victordfmsc/caminafeliz-privacy/scad/img/bandeja_3.png

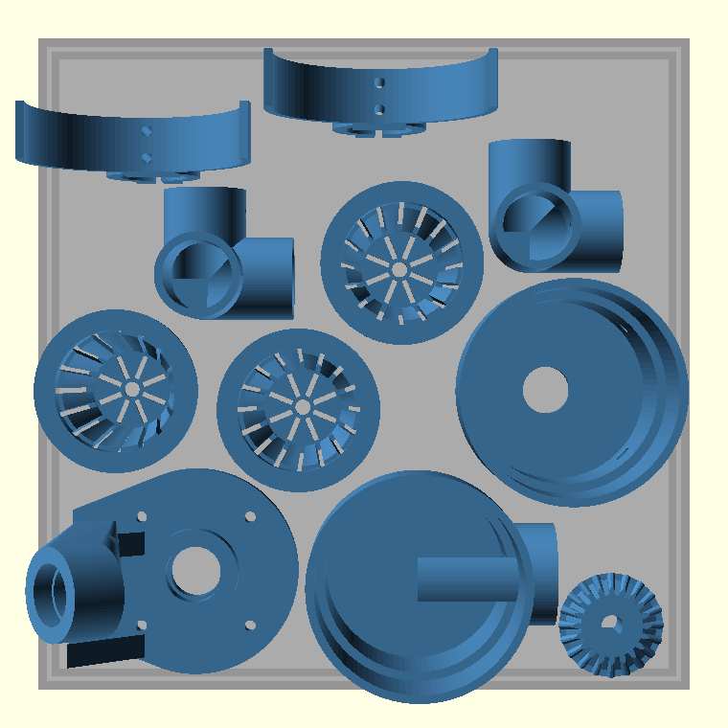
scad/img/bandeja_3.png
