victordfmsc/caminafeliz-privacy/scad/img/piezas/01_tornillo_arquimedes_calibre.png

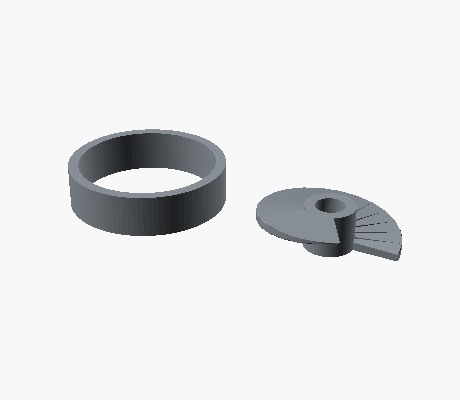
scad/img/piezas/01_tornillo_arquimedes_calibre.png
