victordfmsc/caminafeliz-privacy/scad/img/piezas/01_tornillo_arquimedes_carcasa.png

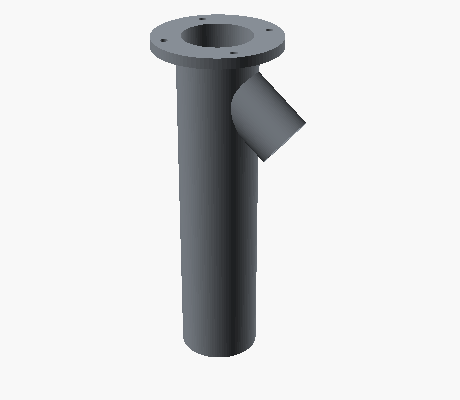
scad/img/piezas/01_tornillo_arquimedes_carcasa.png
