victordfmsc/caminafeliz-privacy/scad/img/piezas/01_tornillo_arquimedes_embudo.png

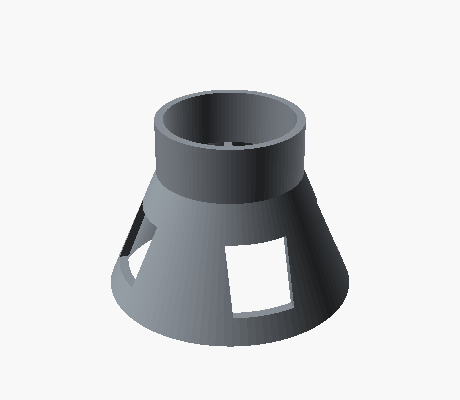
scad/img/piezas/01_tornillo_arquimedes_embudo.png
