victordfmsc/caminafeliz-privacy/scad/img/piezas/02_turbina_savonius_disco_sup.png

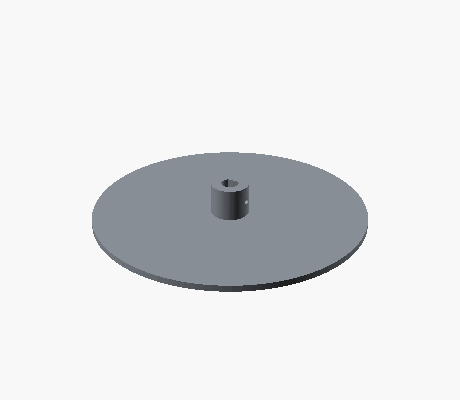
scad/img/piezas/02_turbina_savonius_disco_sup.png
