victordfmsc/caminafeliz-privacy/scad/img/piezas/02_turbina_savonius_rotor.png

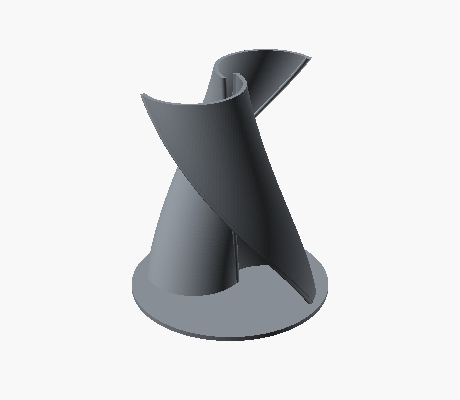
scad/img/piezas/02_turbina_savonius_rotor.png
