victordfmsc/caminafeliz-privacy/scad/img/piezas/03_soporte_rodamientos_acople.png

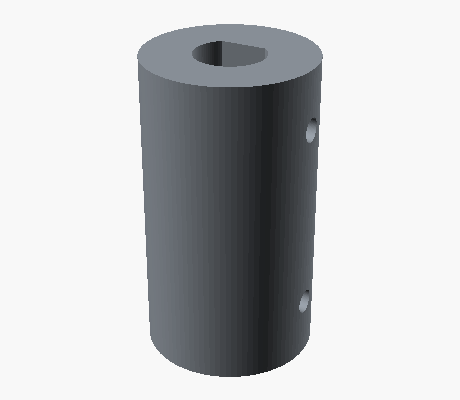
scad/img/piezas/03_soporte_rodamientos_acople.png
