victordfmsc/caminafeliz-privacy/scad/img/piezas/03_soporte_rodamientos_alojamiento.png

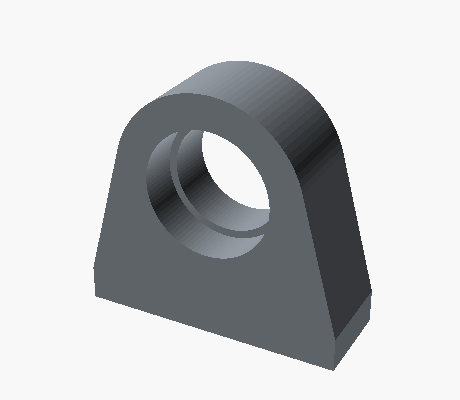
scad/img/piezas/03_soporte_rodamientos_alojamiento.png
