victordfmsc/caminafeliz-privacy/scad/img/piezas/03_soporte_rodamientos_engranaje.png

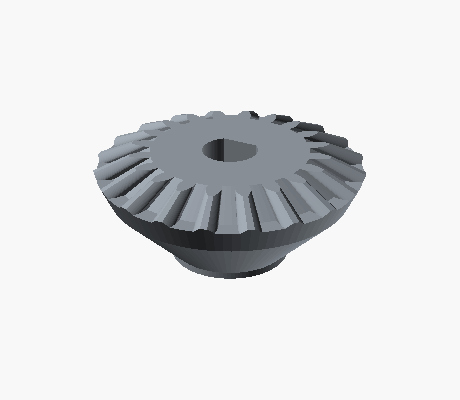
scad/img/piezas/03_soporte_rodamientos_engranaje.png
