victordfmsc/caminafeliz-privacy/scad/img/piezas/03_soporte_rodamientos_soporte.png

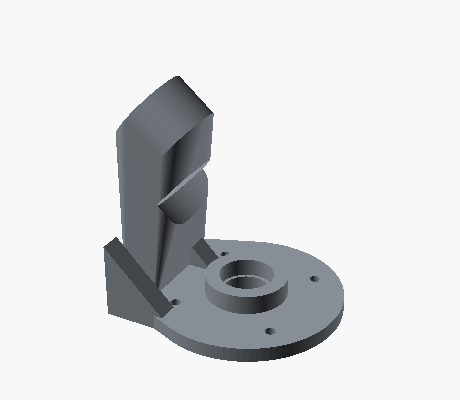
scad/img/piezas/03_soporte_rodamientos_soporte.png
