victordfmsc/caminafeliz-privacy/scad/img/piezas/04_tapones_pvc75_racor.png

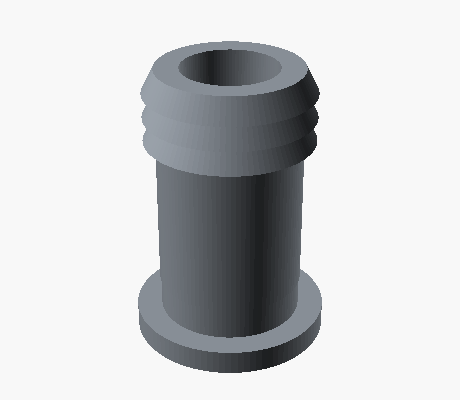
scad/img/piezas/04_tapones_pvc75_racor.png
