victordfmsc/caminafeliz-privacy/scad/img/piezas/04_tapones_pvc75_tapon_a.png

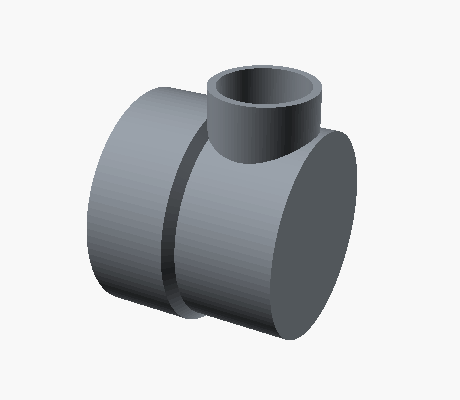
scad/img/piezas/04_tapones_pvc75_tapon_a.png
