victordfmsc/caminafeliz-privacy/scad/img/piezas/04_tapones_pvc75_tapon_b.png

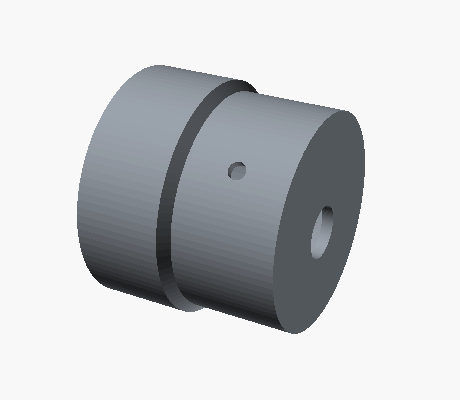
scad/img/piezas/04_tapones_pvc75_tapon_b.png
