victordfmsc/caminafeliz-privacy/scad/img/piezas/05_net_cup_50_plantilla.png

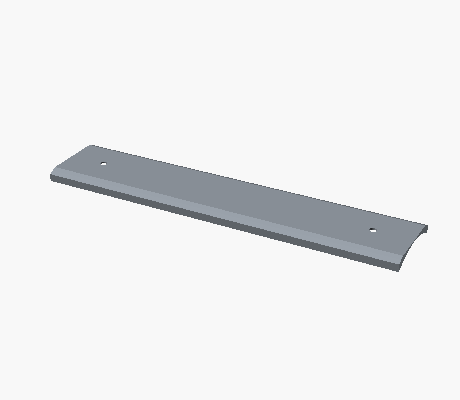
scad/img/piezas/05_net_cup_50_plantilla.png
