victordfmsc/caminafeliz-privacy/scad/img/piezas/06_estructura_abraz_canal.png

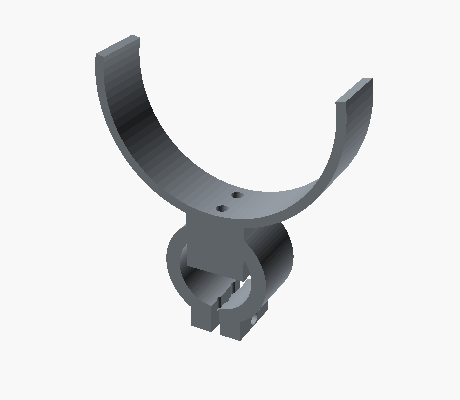
scad/img/piezas/06_estructura_abraz_canal.png
