victordfmsc/caminafeliz-privacy/scad/img/piezas/06_estructura_abraz_carcasa.png

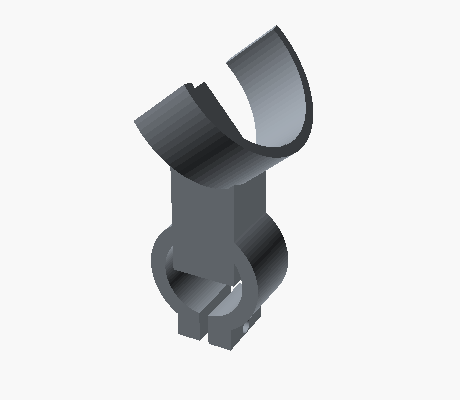
scad/img/piezas/06_estructura_abraz_carcasa.png
