victordfmsc/caminafeliz-privacy/scad/img/piezas/06_estructura_conector_3v.png

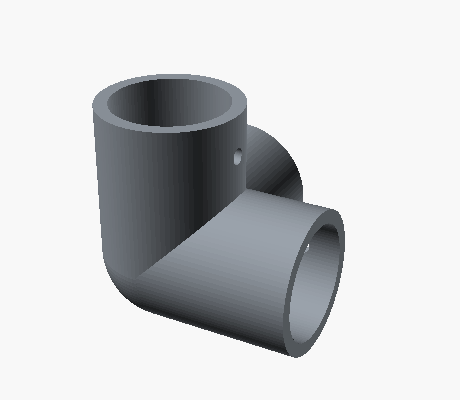
scad/img/piezas/06_estructura_conector_3v.png
