victordfmsc/caminafeliz-privacy/scad/img/piezas/06_estructura_sop_mastil.png

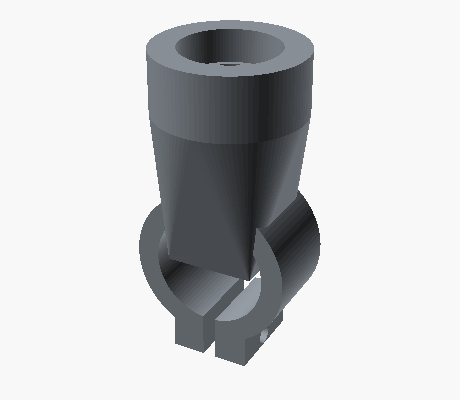
scad/img/piezas/06_estructura_sop_mastil.png
