victordfmsc/caminafeliz-privacy/scad/montaje.tpl.html

# Bomba de Arquímedes eólica

Montaje pieza a pieza de un sistema hidropónico accionado por viento. Veinte piezas impresas, tres cotas que hay que clavar y una ventana de nivel de 23 mm que decide si el invento funciona.

Piezas impresas

20 · 3 bandejas

Comprobaciones

{{N_CHECKS}} · {{ESTADO}}

Caudal en régimen

0,5 L/min

Inclinación de trabajo

40°

Vista general del sistema montado: rotor Savonius sobre mástil vertical, reenvío cónico, tornillo inclinado dentro del depósito y canal horizontal con vasos de cultivo

Conjunto en posición de trabajo, compuesto desde los STL reales. El agua sube por el tornillo, cae a plomo dentro del Tapón A y vuelve al depósito por el rebose.

Por qué funciona

## Cuatro números sostienen el diseño

Un tornillo de Arquímedes no bombea por ser un tornillo: bombea si sus cangilones cierran, si el caudal supera a la fuga y si la cadena de cotas deja el canal por debajo de la descarga y por encima del depósito. Los tres se cumplen, con margen medido.

0,280

Cierre de cangilones

k = S·tan(α)/(2π·Ri) debe ser < 1. El criterio se calcula con el radio interior: con el exterior daría por bueno un paso de 190 mm cuando el máximo real son 54.

0,28 L/min

Caudal neto

1,53 mL por vuelta menos la fuga por la holgura, a las 250 rpm en que el tornillo empieza a centrifugar. Renueva el canal cada 2,6 min.

×35 – ×216

Margen de par

Par estático del rotor frente al que exige el tornillo, de 2 a 5 m/s. Arranca con brisa floja: el sistema está limitado por velocidad, no por fuerza.

23 mm

Ventana de nivel

Entre −10 y +12 mm respecto a la base de la carcasa. Por debajo no coge agua; por encima el retorno deja de bajar por gravedad.

Arranque

## Lo que hace que un molino así no se mueva

El par que exige el tornillo es ridículo: 23 µN·m. Quien decide si arranca no es la carga hidráulica sino el rozamiento del tren, y con un Savonius el par disponible cae con el cuadrado de la velocidad del viento. Las dos cosas juntas explican por qué un aparato aparentemente bien hecho se queda quieto.

Rozamiento del tren | Par de arranque | Par disponible | Ø120×150 | Ø160×200
3 × 608ZZ con grasa de fábrica | 1500 µN·m | viento 1,5 m/s | 447 µN·m | 1058
3 × 608 desengrasado y aceite fino | 120 µN·m | viento 2 m/s | 794 | 1882
Buje del embudo, mojado | 200 µN·m | viento 3 m/s | 1786 | 4234
Engrane cónico impreso | 50 µN·m | viento 4 m/s | 3175 | 7526

3,0 m/s

Con rodamientos de fábrica

1750 µN·m de rozamiento. Es el caso del molino que «apenas se mueve»: hace falta viento fuerte solo para vencerse a sí mismo.

1,4 m/s

Desengrasados

370 µN·m. Quitar la grasa de los tres rodamientos es la intervención de mayor efecto de todo el proyecto, y es gratis.

0,9 m/s

Y rotor Ø160×200

El par del Savonius va con D²H: subir el rotor lo multiplica por 2,4 y además baja las rpm, que es lo que interesa porque el caudal ya está saturado.

2,4 m/s

Con álabe recto

Un Savonius de dos palas rectas tiene posiciones en las que el coeficiente de par cae a 0,10: puntos muertos. El álabe helicoidal de 120° los elimina.

### El emplazamiento pesa más que cualquier pieza

El par va con v², así que perder velocidad de viento se paga al cuadrado. Un balcón con barandilla, pared al lado y alero encima puede dejar la mitad de la velocidad libre, y con ella un cuarto del par.

Velocidad en el emplazamiento | Par que queda | Viento libre necesario para arrancar
100 % (mástil despejado) | 100 % | 1,4 m/s
70 % (por encima del pretil) | 49 % | 2,0 m/s
50 % (tras la barandilla) | 25 % | 2,7 m/s
35 % (rincón abrigado) | 12 % | 3,9 m/s

Regla práctica: el rotor tiene que estar por encima del pretil y a más de un diámetro de rotor de cualquier superficie. Si te obliga a subir el mástil 40 cm, súbelo: rinde más que cualquier cambio de pieza.

### Dos pruebas antes de meter agua

#### Parada libre

≥ 10 s desde 200 rpm

Con el tren montado y seco, lanza el rotor con la mano y cronometra. Bien ajustado y desengrasado ronda los 25 s. Si se para en menos de 10, no arrancará con brisa: busca el punto duro antes de seguir.

#### Par de arranque

10 g en un hilo

Enrolla un hilo en la varilla de Ø8 y cuelga peso. Con unos 10 g debe empezar a girar. Si necesita 40, los rodamientos siguen con la grasa de fábrica.

#### Si notas puntos duros

casi siempre es el engrane

Un par cónico montado 1 mm fuera de su cota entra forzado. Afloja el prisionero y separa el engranaje medio milímetro hasta que gire suave en toda la vuelta.

#### Cómo desengrasar

tres rodamientos, diez minutos

Quita un escudo con la punta de un cutter, lava la grasa con alcohol o disolvente, seca y pon una gota de aceite fino. Vuelve a poner el escudo por el lado del agua.

Cadena de cotas

## Dónde cae cada nivel

Todas las alturas están referidas a la base del tubo de la carcasa. La geometría de la conexión —radio del canal, manguito y carrera de la boquilla— consume unos 100 mm de altura, y por eso el tornillo de 180 mm no sobra: el mínimo viable son 157.

La boquilla es un tramo recto girado exactamente la inclinación de la carcasa: con el conjunto montado queda a plomo y su boca sale cortada en horizontal. Encaja 14 mm dentro del manguito con 1 mm de holgura radial, que admite 8° de desviación sin tocar.

Reenvío cónico

## Las dos cotas que no se pueden montar a ojo

Con turbina de eje vertical y tornillo a 40°, el ángulo entre ejes no es 90° sino 130°, y en una relación 1:1 cada cono primitivo vale la mitad: 65°. Los dos ejes se cortan en un punto —el ápice— y la posición axial de cada engranaje respecto a ese punto es lo que define el engrane.

Ambas cotas se miden entre la cara del buje que aloja el rodamiento y la base del cubo del engranaje. Son la forma práctica de colocar el ápice donde toca sin tener que medir hasta un punto que está en el aire.

Inventario

## Las veinte piezas

Todas salen de los seis módulos paramétricos y se imprimen en tres bandejas. Además hacen falta: varilla inoxidable Ø8 (257 y 299 mm), tres rodamientos 608ZZ, ocho prisioneros M3, diez tornillos M4, tubo PVC Ø75, tubo Ø25 para el bastidor y manguera Ø12 para el retorno.

{{INVENTARIO}}

Montaje

## Diez pasos, en este orden

El orden no es indiferente: hay dos pasos que solo se pueden hacer antes de otro. El embudo se monta con la varilla ya puesta, y el canal se coloca al final, deslizándolo bajo la boquilla en vez de mover la carcasa.

{{PASOS}}

Verificación

## Acta de comprobación

Estas comprobaciones no están escritas a mano: verificacion.py hace que OpenSCAD evalúe cada módulo y devuelva sus propias variables, y sobre esos números comprueba ajustes, alineaciones y límites físicos. Si cambias un parámetro y algo deja de cuadrar, la tabla lo dice.

{{VERIFICACION}}

Límites

## Lo que este sistema no puede hacer

Funciona, pero conviene saber dónde están sus techos antes de plantar.

#### El caudal tiene tope de volumen

250 rpm · saturado desde 1,6 m/s

Por encima de esa velocidad la fuerza centrífuga vacía los cangilones. La turbina llega ahí con una brisa mínima, así que el tornillo está saturado casi siempre: el caudal no lo pone el viento, lo pone el volumen de cangilón.

#### Tres o cuatro lechugas por tramo

51 mg/h aportados · 15 mg/h por planta

El límite no es el agua sino el oxígeno disuelto. Con albahaca o lechuga baby la demanda cae a la mitad y caben seis o siete.

#### Las calmas se notan en minutos

7 min de reserva disuelta

Lo que sostiene la planta cuando para el viento no es el agua almacenada sino la raíz que respira en aire húmedo. Por eso el Tapón B lleva respiraderos y el manguito de entrada no cierra.

#### La nivelación es fina

ventana de 23 mm

El depósito tiene que quedar con su lámina prácticamente a la altura de la base de la carcasa. Es la única cota del montaje que no se corrige después apretando un tornillo.

Corrección sobre la velocidad crítica. Una versión anterior de esta página daba 427 rpm, usando la fórmula de Muysken N = 50/D2/3. Esa fórmula está calibrada para tornillos hidráulicos de obra: entre 0,5 y 2 m mantiene la aceleración centrípeta del radio exterior en 1,3–1,4 g, pero extrapolada a Ø40 pide 4,1 g, que no es el mecanismo. El centrifugado exige N ∝ D−1/2: recalibrando sobre el punto de 1 m salen 250 rpm, y el criterio puro de tambor (ω²R = g) da 211. El caudal baja de 0,5 a 0,28 L/min.

Cómo subir cada techo

## Seis intervenciones, por rentabilidad

Las dos primeras no tocan el diseño y se llevan la mitad del problema. Las cuatro siguientes se encadenan: bajar la inclinación desbloquea a la vez más volumen de cangilón, una ventana de nivel más ancha y una reducción dentro del propio par cónico.

| Intervención | Techo | Ganancia | Coste
01 | Sombrear canal y depósito: 24 → 20 °C | plantas, calmas | +40 % plantas | ninguno
02 | Válvula de flotador en el depósito | nivelación | el techo desaparece | ~5 €, pieza comercial
03 | Recogedor anular en la corona en vez de boquilla lateral | nivelación | ventana 23 → 63 mm | rediseñar el vertido
04 | Inclinación 40° → 32°, con el recogedor | caudal | ×1,6 · ventana 45 mm | un parámetro y reverificar
05 | Inclinación 25° y reducción 1,5:1 en el propio par | caudal | ×2,4 sin etapa extra | rediseñar los engranajes
06 | Tornillo Ø40 → Ø50 | caudal | ×2,9 · ×4,3 con 32° | +40 % filamento, 4 piezas

Se acumulan: sombra más Ø50 a 32° llevan el caudal de 0,28 a 1,26 L/min y las plantas de 3–4 a unas 20. La reducción dentro del par cónico solo es geométricamente posible por debajo de 30°: a 40° una relación 2:1 exigiría un engranaje de corona, que no se puede extruir.

### Lo que no funciona

#### Tornillo de varias entradas

−14 % por cada entrada extra

Parece que dos entradas dupliquen los cangilones, pero el agua está limitada por el mismo plano y el mismo anillo: cada filete añadido solo le quita sitio.

#### Más volumen de canal para las calmas

haría falta ×10 para una hora

La reserva es lineal con el volumen y la demanda no baja. Un canal el doble de largo aguanta el doble de minutos y sostiene las mismas plantas.

#### Depósito acumulador elevado

18 L para una hora

Funciona en principio —se llena con ráfagas y drena despacio— pero tiene que ir por encima de la lámina del canal y por debajo de la boquilla: 45 mm de altura útil para 18 litros son 40 × 40 cm de planta.

#### Reducción como multiplicador de caudal

no sube el techo

Solo elige a qué viento se alcanza. Sirve como seguro contra el sobrerrégimen —a 6 m/s el tornillo gira casi cuatro veces por encima de su crítica— no para bombear más.

Generado desde la geometría real: render_stl.sh → 08_montaje.scad → infografia.py Cotas verificadas por verificacion.py Hidráulica y agronomía en analisis_bomba.py
