victordfmsc/caminafeliz-privacy/scad/img/montaje/paso_2.png

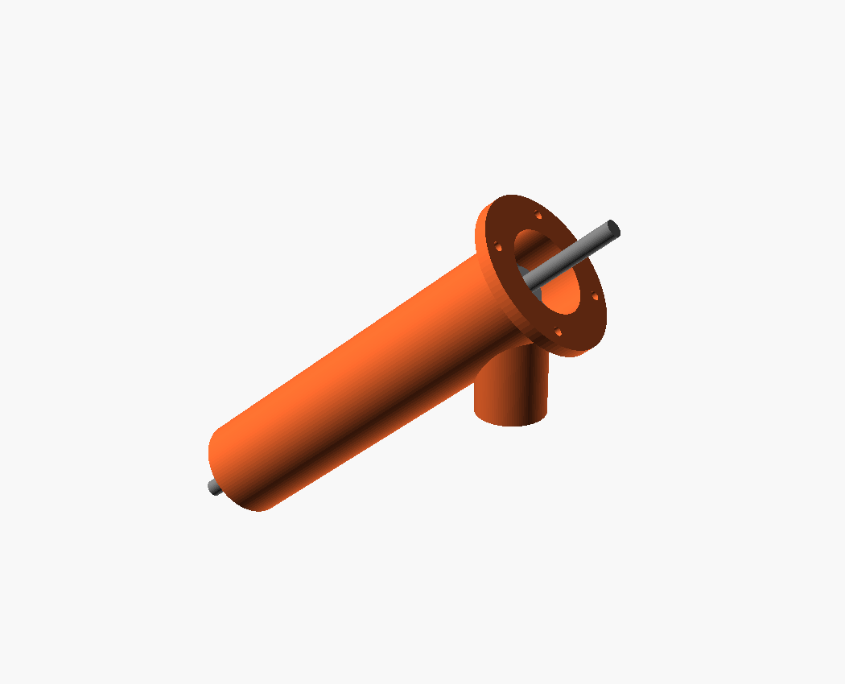
scad/img/montaje/paso_2.png
