victordfmsc/caminafeliz-privacy/scad/img/montaje/paso_4.png

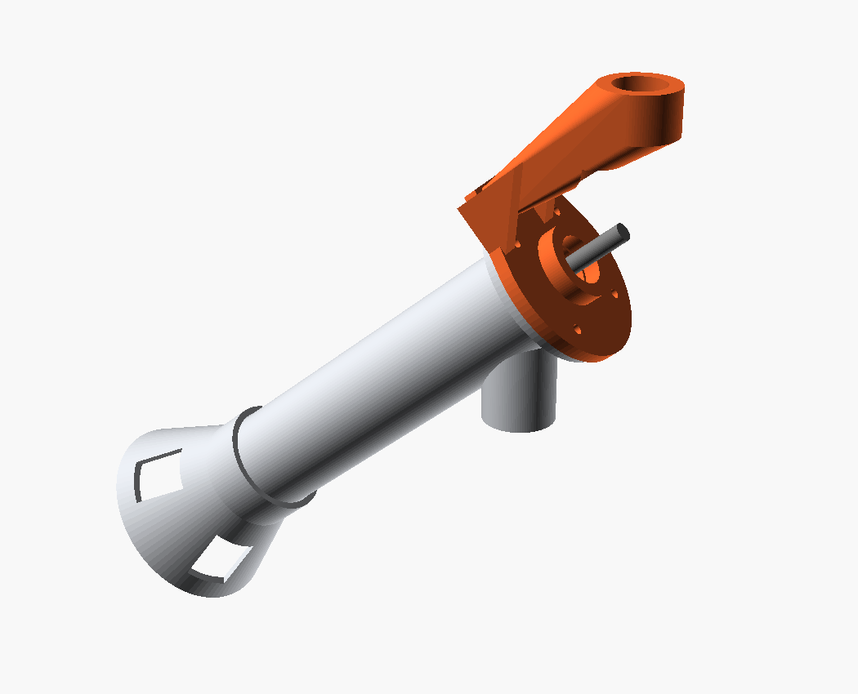
scad/img/montaje/paso_4.png
