victordfmsc/caminafeliz-privacy/scad/img/montaje/paso_6.png

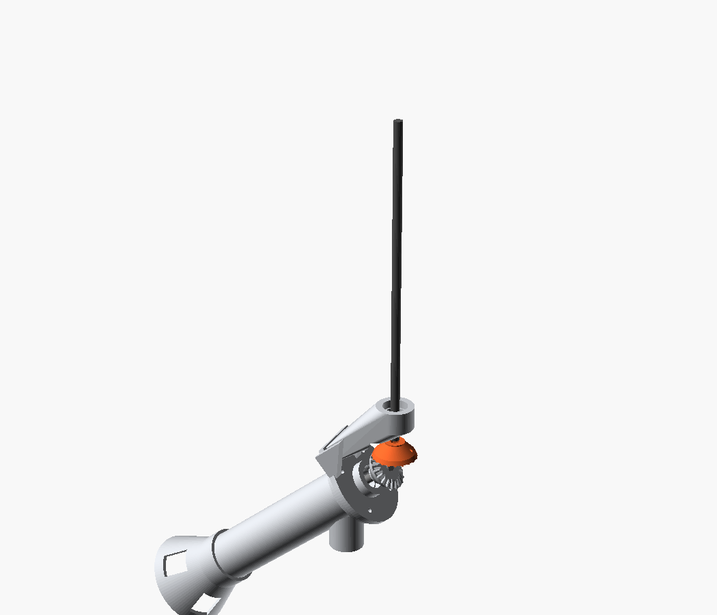
scad/img/montaje/paso_6.png
