victordfmsc/caminafeliz-privacy/scad/img/montaje/paso_8.png

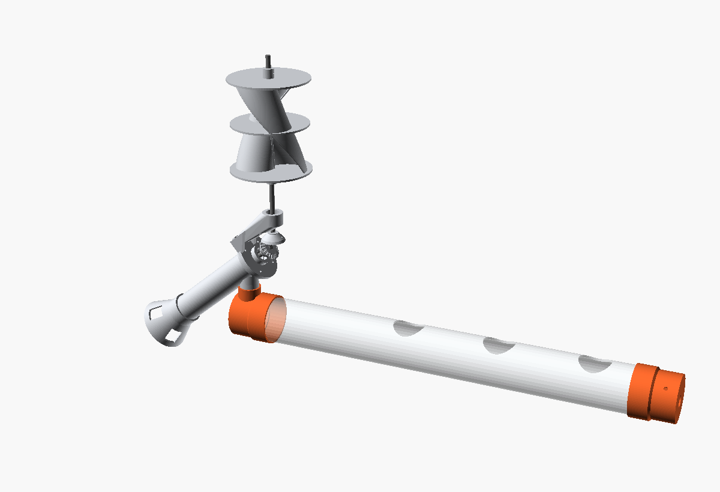
scad/img/montaje/paso_8.png
