victordfmsc/caminafeliz-privacy/scad/img/montaje/paso_10.png

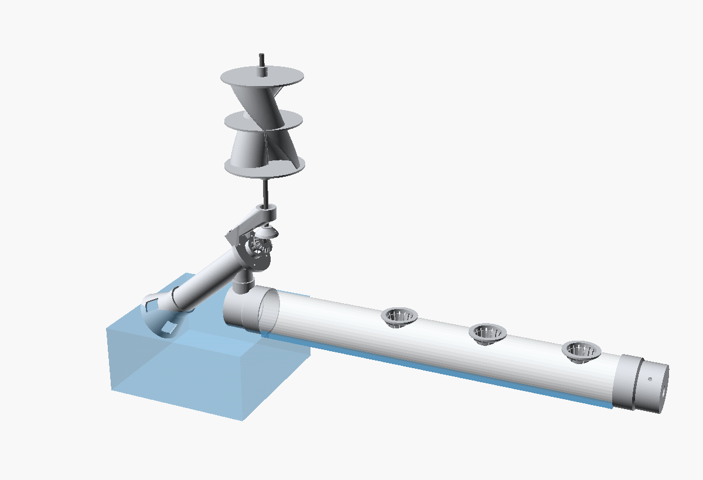
scad/img/montaje/paso_10.png
