victordfmsc/caminafeliz-privacy/(commit log)

2026-08-24 Añadir modelos OpenSCAD de la bomba de Arquímedes eólica
    Cinco módulos paramétricos, sin librerías externas, con $fn=100,
    pared mínima de 3 mm y tolerancia de 0.3 mm en uniones mecánicas:
    1. Tornillo de Arquímedes (Ø40, paso 30, largo 180) + carcasa Ø40.6
    con embudo de entrada desmontable y boquilla de vertido.
    2. Turbina Savonius de 2 álabes (Ø120 x 150) con discos de refuerzo.
    3. Torreta con dos alojamientos 608 a 90°, chumacera suelta, par de
    engranajes cónicos 1:1 de evolvente generada en el propio script
    y acople rígido alternativo.
    4. Tapones de entrada y de rebose para tubo PVC Ø75, con lámina de
    agua de 25 mm calculada sobre la base interior del tubo.
    5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
    [01_tornillo_arquimedes.scad, 02_turbina_savonius.scad, 03_soporte_rodamientos.scad, 04_tapones_pvc75.scad, 05_net_cup_50.scad]
2026-08-24 Ajustar los modelos a la configuración real de la planta
    El infográfico del sistema fija dos cosas que obligan a rehacer la
    cinemática:
    - El tornillo trabaja inclinado, no vertical. Un Arquímedes vertical no
    forma cangilones cerrados. Se añade el parámetro de inclinación (40°)
    y el criterio de Rorres: Λ = S·tan(α)/(2πRo) debe ser < 1; con el paso
    de 30 mm y Ø40 del enunciado sale Λ = 0.20, en el entorno del óptimo.
    La boquilla pasa a ser un tramo recto girado la inclinación, con lo
    que cae a plomo y no necesita codo; el embudo pierde las patas y gana
    ventanas de admisión.
    - La turbina es de eje vertical con álabes helicoidales. Se añade la
    torsión (120°, l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
    [01_tornillo_arquimedes.scad, 02_turbina_savonius.scad, 03_soporte_rodamientos.scad, 04_tapones_pvc75.scad, 06_estructura.scad, 07_conjunto_general.scad]
2026-08-24 Corregir la hidráulica del tornillo y el balance de oxígeno del canal
    Análisis físico (analisis_bomba.py, reproducible y validado contra el
    límite analítico de paso pequeño, 0.3180):
    - El criterio de cierre de cangilones que se citaba usa el radio
    EXTERIOR y es cuatro veces más permisivo de lo debido. El correcto
    sale del punto de silla de la hélice del canto interior:
    k = S·tan(a)/(2·pi·Ri) < 1. Paso máximo real: 53.5 mm, no 190.
    - El paso de 30 mm dejaba el caudal neto a 300 rpm prácticamente en
    cero. Integrando volumen de cangilón y fuga, el óptimo está entre 12
    y 20 mm: paso 15 mm (12 vueltas exactas en 180 mm).
    - La holgura radial es el parámetro más sensib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
    [01_tornillo_arquimedes.scad, 04_tapones_pvc75.scad, 05_net_cup_50.scad]
2026-08-24 Repartir el sistema en 3 bandejas de P2S y quitar los soportes evitables
    Empaquetado (bandejas.py): en vez de colocar a ojo, lee los STL, aplica a
    cada pieza su rotación de impresión y empaqueta las siluetas reales
    —envolvente convexa de la planta, rasterizada a 1 mm y dilatada media
    separación— en lugar de las cajas envolventes. Dos discos de Ø132 no caben
    lado a lado en 246 mm pero sí en diagonal, y eso solo lo ve un
    empaquetador que trabaje con la forma: con cajas salían 5 bandejas, con
    siluetas salen 3, que es el mínimo alcanzable (la suma de huellas da 2.45
    bandejas y la primera ya va al 89 %).
    El reparto respeta el orden: el calibre va en la primera bandeja y el
    tornillo y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
    [04_tapones_pvc75.scad]
2026-08-24 Verificar la cadena de cotas y publicar la guía de montaje
    verificacion.py: 34 comprobaciones que no están escritas a mano. Hace que
    OpenSCAD evalúe cada módulo y devuelva por ECHO sus propias variables, y
    sobre esos números comprueba ajustes, alineación de taladros, cotas de
    montaje del par cónico, longitudes de varilla, cadena de cotas del vertido
    y ventana de nivel del depósito. Todas pasan.
    Dos fallos reales que ha destapado:
    - La abrazadera de carcasa del módulo 6 fijaba a mano un Ø46,6 que había
    dejado de ser el diámetro exterior real de la carcasa (46,3 desde que la
    holgura de la hélice bajó a 0,15). La cuna quedaba 0,9 mm suelta.
    - La unión boquilla-manguito ten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
    [04_tapones_pvc75.scad, 05_net_cup_50.scad, 06_estructura.scad, 08_montaje.scad]
2026-08-25 Corregir la velocidad crítica del tornillo y analizar los cuatro techos
    La cifra de 427 rpm venía de aplicar Muysken (N = 50/D^(2/3)) a un tornillo
    de 40 mm. Esa fórmula está calibrada para tornillos hidráulicos de obra:
    entre 0,5 y 2 m mantiene la aceleración centrípeta del radio exterior en
    1,3-1,4 g, pero extrapolada a Ø40 pide 4,1 g, que no es el mecanismo. El
    centrifugado exige N proporcional a D^(-1/2), no a D^(-2/3). Recalibrando
    sobre el punto de 1 m salen 250 rpm; el criterio puro de tambor da 211.
    Consecuencias: el caudal baja de 0,50 a 0,28 L/min, el tornillo satura
    desde 1,6 m/s en vez de 3, y el sistema sostiene 3-4 lechugas en vez de 4.
    mejoras.py cuantifica qué inte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
2026-08-25 Analizar el arranque: el enemigo es el rozamiento, no la carga
    El margen de par que se publicaba (x35 a x216) comparaba el par del rotor
    con el par HIDRAULICO del tornillo, que son 23 uN m. Esa no es la
    comparacion util. Quien decide si el molino arranca es el rozamiento del
    tren, y tres rodamientos 608ZZ con la grasa de fabrica suman del orden de
    1500 uN m, mas 200 del buje y 50 del engrane.
    Con eso el viento de arranque son 3,0 m/s. Desengrasados baja a 1,4 m/s, y
    con rotor Ø160x200 a 0,9. Quitar la grasa es la intervencion de mayor
    efecto del proyecto y no cuesta nada.
    Dos factores mas, cuantificados en arranque.py:
    - El emplazamiento se paga al cuadrado. Un balcon tras barandilla pue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
